broskifoo/resistive-sensor-signal-conditioning-pcb/Resistive_Sensor_PCB.kicad_pcb

## KiCad design Resistive_Sensor_PCB.kicad_pcb (2026-10-12)

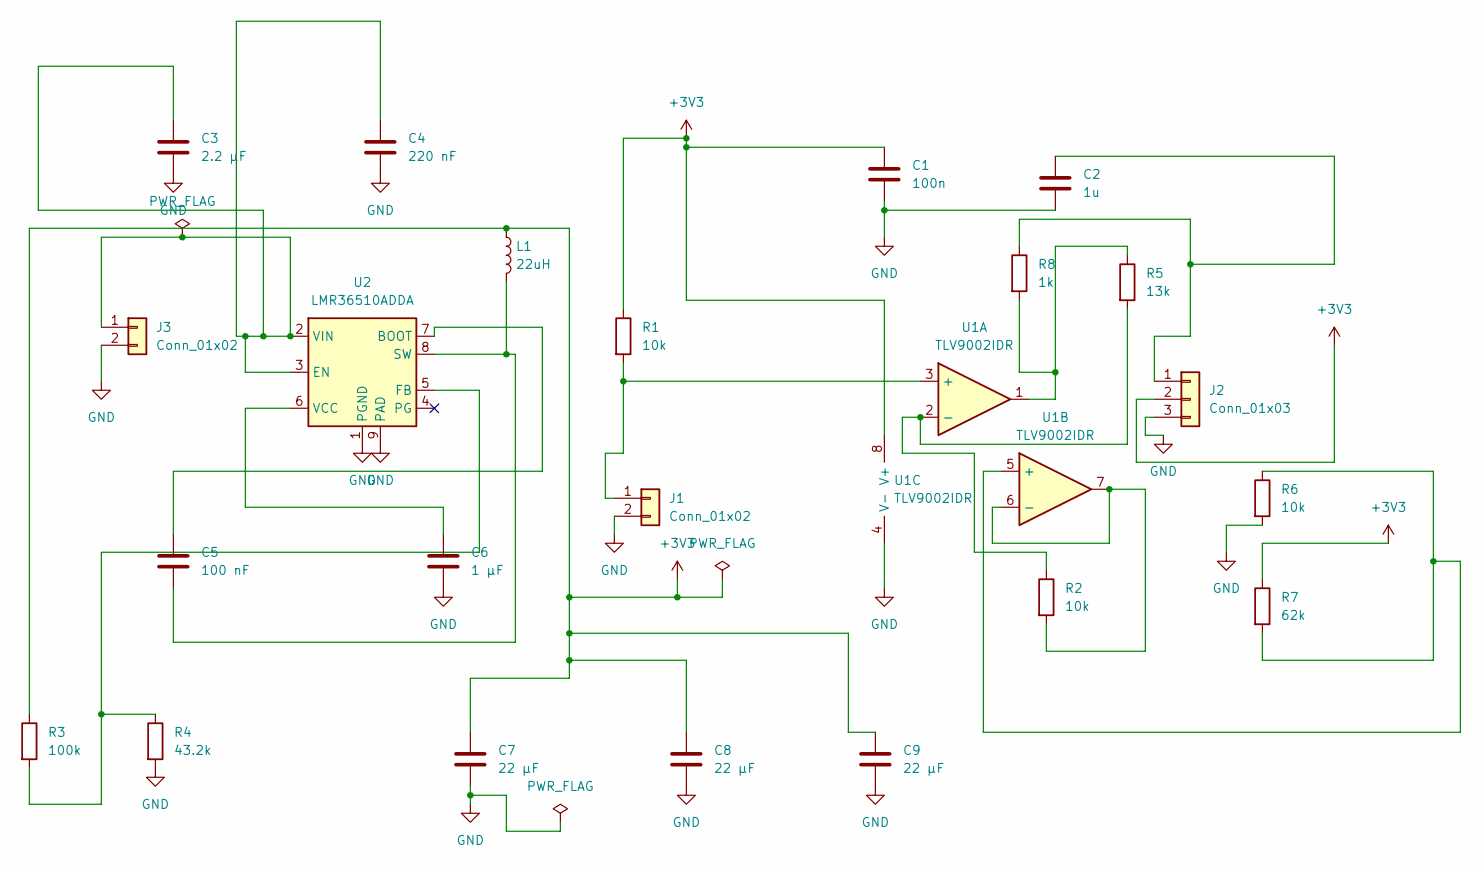
[picture p1: schematic Resistive_Sensor_PCB.kicad_sch]

Parts:
C1: 100n; C_0805_2012Metric
C2: 1u; C_0805_2012Metric
C3: 2.2 µF; C_0805_2012Metric
C4: 220 nF; C_0805_2012Metric
C5: 100 nF; C_0805_2012Metric
C6: 1 µF; C_0805_2012Metric
C7, C8, C9: 22 µF; C_0805_2012Metric
J1, J3: Conn_01x02; PinHeader_1x02_P2.54mm_Vertical
J2: Conn_01x03; PinHeader_1x03_P2.54mm_Vertical
L1: 22uH; L_Bourns_SRN6045TA
R1, R2, R6: 10k; R_0805_2012Metric
R3: 100k; R_0805_2012Metric
R4: 43.2k; R_0805_2012Metric
R5: 13k; R_0805_2012Metric
R7: 62k; R_0805_2012Metric
R8: 1k; R_0805_2012Metric
U1: TLV9002IDR; SOIC-8_3.9x4.9mm_P1.27mm
U2: LMR36510ADDA; Texas_HTSOP-8-1EP_3.9x4.9mm_P1.27mm_EP2.95x4.9mm_Mask2.4x3.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

Connections:
+3V3: C1.1, C7.1, C8.1, C9.1, J2.2, L1.1, R1.1, R3.1, R7.1, U1.8 (V+)
GND: C1.2, C2.2, C3.2, C4.2, C6.2, C7.2, C8.2, C9.2, J1.2, J2.3, J3.2, R4.2, R6.2, U1.4 (V-), U2.1 (PGND), U2.9 (PAD)
unnamed: J1.1, R1.2, U1.3 (+)
unnamed: C2.1, J2.1, R8.1
unnamed: C3.1, C4.1, J3.1, U2.2 (VIN), U2.3 (EN)
unnamed: R5.1, R8.2, U1.1
unnamed: R2.1, R5.2, U1.2 (-)
unnamed: R6.1, R7.2, U1.5 (+)
unnamed: R2.2, U1.6 (-), U1.7
unnamed: C5.1, U2.7 (BOOT)
unnamed: R3.2, R4.1, U2.5 (FB)
unnamed: C5.2, L1.2, U2.8 (SW)
unnamed: C6.1, U2.6 (VCC)

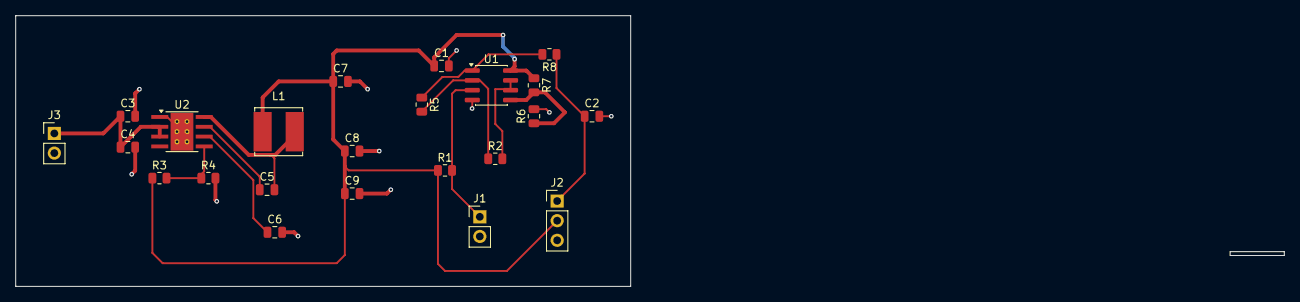
[picture p2: board Resistive_Sensor_PCB.kicad_pcb from above]

Board: 2 copper layers, 79.5 x 35.0 mm, 23 parts (0 on the bottom side), 13 nets.
